Real-Exo/PP113/README.md

Portable version of the Project 113 headphone amplifier, with added BlueTooth and 3D printable case.
Powered by 4 removable 18650 Li-ion cells, have to be charged externally.
Kicad 7.0 schematics & PCB layouts.
MPLAB X IDE firmware project.
FreeCAD case design files & gcode.
