Real-Exo/PP113/Portable Project 113 Headphone Amplifier/BOM/P113 BT Daughterboard.ods

# | Reference | Qty | Value | Footprint | DNP | Partcode
1 | C1, C3, C4, C5, C6 | 5 | 10µF | Capacitor_SMD:C_0805_2012Metric_Pad1.18x1.45mm_HandSolder |  | GRM21BR61H106KE43K
2 | C2 | 1 | 150pF | Capacitor_SMD:C_0805_2012Metric_Pad1.18x1.45mm_HandSolder |  | 885012007005
3 | J1 | 1 | BT Power | Connector_PinHeader_2.54mm:PinHeader_1x05_P2.54mm_Vertical |  | Standard 2.54 pin header
4 | J2 | 1 | BT Audio | Connector_PinHeader_2.54mm:PinHeader_1x05_P2.54mm_Vertical |  | Standard 2.54 pin header
5 | L1 | 1 | 100µH | Inductor_SMD:L_Changjiang_FNR4026S |  | SRN4026-101M
6 | L2 | 1 | TBD | Inductor_THT:L_Axial_L11.0mm_D4.5mm_P15.24mm_Horizontal_Fastron_MECC |  | Bridge or 100mH axial inductor for filtering
7 | MOD1 | 1 | MH-M18 | My_Footprints:MH-M18 |  | MH-M18 BT module
8 | R1, R2 | 2 | * | Resistor_SMD:R_0805_2012Metric_Pad1.20x1.40mm_HandSolder | X
9 | R3 | 1 | # | Resistor_SMD:R_0805_2012Metric_Pad1.20x1.40mm_HandSolder | X
10 | R4 | 1 | 126K | Resistor_SMD:R_0805_2012Metric_Pad1.20x1.40mm_HandSolder |  | RT0805BRE07126KL
11 | R5 | 1 | 24K | Resistor_SMD:R_0805_2012Metric_Pad1.20x1.40mm_HandSolder |  | RT0805FRE0724KL
12 | R6, R7 | 2 | 0 | Resistor_SMD:R_0805_2012Metric_Pad1.20x1.40mm_HandSolder |  | 0 ohm bridge
13 | R8, R9 | 2 | 22K | Resistor_SMD:R_0805_2012Metric_Pad1.20x1.40mm_HandSolder |  | RK73B2ATTD223J
14 | U1 | 1 | RT6208 | Package_TO_SOT_SMD:SOT-23-6 |  | RT6208GE
