Real-Exo/PP113/Portable Project 113 Headphone Amplifier/BOM/P113 Portable Headphone Amp.ods

# | Reference | Qty | Value | Footprint | DNP | Partcode
1 | BT11 | 1 | ~ | My_Footprints:Quad PCB mounted 18650 li-ion holder |  | BK-18650-PC8
2 | C11, C12, C13, C14, C15, C16 | 6 | 2.2µF | Capacitor_SMD:C_1206_3216Metric_Pad1.33x1.80mm_HandSolder |  | C1206C225J5REC7210
3 | C17, C18, C19, C21, C31, C32, C47, C48, C49, C110 | 10 | 100n | My_Footprints:C_0402_1005Metric_Pad0.74x0.62mm_HandSolder |  | CL05A104KA5NNNC
4 | C22, C23, C24, C27, C212, C213, C218 | 7 | 10µF | Capacitor_SMD:C_0805_2012Metric_Pad1.18x1.45mm_HandSolder |  | GRM21BR61H106KE43K
5 | C25, C26, C43, C44, C45, C46, C54, C55, C56, C512, C513, C514, C517, C518 | 14 | 100n | Capacitor_SMD:C_0805_2012Metric_Pad1.18x1.45mm_HandSolder |  | CL21B104KBCNFNC
6 | C28, C29, C210, C211 | 4 | 100µF | Capacitor_THT:CP_Radial_D6.3mm_P2.50mm |  | ESL107M035AE3AA
7 | C41, C42 | 2 | 1µF | My_Footprints:WIMA_1µF |  | MKP2C041001N00MN00
8 | C51, C59 | 2 | 100µF | Capacitor_SMD:CP_Elec_8x5.4 |  | UWP0J101MCL1GB
9 | C52, C53, C510, C511 | 4 | 100µF | Capacitor_SMD:CP_Elec_6.3x5.4_Nichicon |  | UWX0J101MCL1GB
10 | C57, C58, C515, C516 | 4 | 47µF | Capacitor_SMD:CP_Elec_6.3x5.7 |  | A768EB476M1VLAE042
11 | C214, C215, C216, C217, C219 | 5 | 1µF | Capacitor_SMD:C_0805_2012Metric_Pad1.18x1.45mm_HandSolder |  | CL21B105KBFNNNE
12 | C220 | 1 | 1µF | My_Footprints:C_0402_1005Metric_Pad0.74x0.62mm_HandSolder |  | GRM155R61E105KA12J
13 | D11, D12, D23, D24, D27 | 5 | SBR0560S1Q | Diode_SMD:D_SOD-123 |  | SBR0560S1Q-7 | ATTENTION: Errata, replace D12 with 0 ohm bridge
14 | D21, D22 | 2 | BZT52C18 | Diode_SMD:D_SOD-123 |  | BZT52C18-7-F
15 | D25, D26, D51, D52, D53, D54 | 6 | 1N4148W | Diode_SMD:D_SOD-123 |  | 1N4148W-TP
16 | D31 | 1 | LED | My_Footprints:LED_Holder |  | 3mm 2color 2pin LED
17 | D41, D42, D55, D56 | 4 | SMF20CA | Diode_SMD:D_SOD-123 |  | SMF20CA
18 | D43, D45, D47, D49 | 4 | BAS16TS | Diode_SMD:D_SOD-523 |  | BAS16TS_R1_00001
19 | D44, D46, D48, D410 | 4 | 5.1V | Diode_SMD:D_SOD-323 |  | PZU5.1B1A,115
20 | D411, D412, D413 | 3 | BAS16TS | Diode_SMD:D_SOD-523 |  | BAS16TS_R1_00001
21 | F11 | 1 | PTC 0.35A | Fuse:Fuse_1812_4532Metric_Pad1.30x3.40mm_HandSolder |  | SMD1812B035TF/30
22 | F12, F13, F14, F15, F16 | 5 | PTC 0.05A | Fuse:Fuse_1206_3216Metric_Pad1.42x1.75mm_HandSolder |  | SMD1206B005TF
23 | J31 | 1 | ICSP | Connector_PinSocket_2.54mm:PinSocket_1x05_P2.54mm_Vertical |  | SSW-105-01-T-S
24 | J41, J51 | 2 | Line in, HP out | My_Footprints:3-5mm_connector |  | STX-3120-5B
25 | J42 | 1 | BT daughterboard audio | Connector_PinSocket_2.54mm:PinSocket_1x05_P2.54mm_Vertical |  | SSW-105-01-T-S
26 | J43 | 1 | BT daughterboard power | Connector_PinSocket_2.54mm:PinSocket_1x05_P2.54mm_Vertical |  | SSW-105-01-T-S
27 | Q11, Q12, Q13, Q14 | 4 | BSS84W | Package_TO_SOT_SMD:SOT-323_SC-70 |  | BSS84WT106
28 | Q15, Q16, Q17, Q18, Q41, Q42, Q43 | 7 | BSS138W | Package_TO_SOT_SMD:SOT-323_SC-70 |  | BSS138W-7-F
29 | Q21, Q23 | 2 | BC817 | Package_TO_SOT_SMD:SOT-23 |  | BC817-40,215
30 | Q22, Q24 | 2 | BC807 | Package_TO_SOT_SMD:SOT-23 |  | BC807-40,215
31 | Q25, Q26 | 2 | DMC3025LSD | Package_SO:SO-8_3.9x4.9mm_P1.27mm |  | DMC3025LSD-13
32 | Q51, Q53 | 2 | BCP56 | Package_TO_SOT_SMD:SOT-223-3_TabPin2 |  | BCP56-10HX
33 | Q52, Q54 | 2 | BCP53 | Package_TO_SOT_SMD:SOT-223-3_TabPin2 |  | BCP53-10HX
34 | R11, R12, R13, R14, R21, R22, R23, R24, R25, R26, R27, R28, R33, R46, R47, R49, R113, R410, R412 | 19 | 100K | My_Footprints:R_0402_1005Metric_Pad0.72x0.64mm_HandSolder |  | ERJ-2GEJ104X
35 | R15, R16, R17, R18, R19, R45, R48, R110, R111, R112, R411 | 11 | 1K | My_Footprints:R_0402_1005Metric_Pad0.72x0.64mm_HandSolder |  | ERJ-2GEJ102X
36 | R29, R52, R210, R213, R214, R511 | 6 | 100 | Resistor_SMD:R_0805_2012Metric_Pad1.20x1.40mm_HandSolder |  | RK73B2ATTD101J
37 | R31 | 1 | 10K | My_Footprints:R_0402_1005Metric_Pad0.72x0.64mm_HandSolder |  | ERJ-2GEJ103X
38 | R32 | 1 | 470 | My_Footprints:R_0402_1005Metric_Pad0.72x0.64mm_HandSolder |  | ERJ-2GEJ470X
39 | R34 | 1 | 2K2 | Resistor_SMD:R_0805_2012Metric_Pad1.20x1.40mm_HandSolder |  | RK73B2ATTD222J
40 | R41, R42 | 2 | 22K | Resistor_SMD:R_1206_3216Metric_Pad1.30x1.75mm_HandSolder |  | ERJ-P08J223V
41 | R43, R44 | 2 | 1K | Resistor_SMD:R_2512_6332Metric_Pad1.40x3.35mm_HandSolder |  | CRGP2512F1K0
42 | R53, R512 | 2 | 1K | Resistor_SMD:R_0805_2012Metric_Pad1.20x1.40mm_HandSolder |  | RK73B2ATTD102J
43 | R54, R513 | 2 | 22K | Resistor_SMD:R_0805_2012Metric_Pad1.20x1.40mm_HandSolder |  | RK73B2ATTD223J
44 | R55, R56, R514, R515 | 4 | 6K8 | Resistor_SMD:R_0805_2012Metric_Pad1.20x1.40mm_HandSolder |  | RK73B2ATTD682J
45 | R57, R58, R510, R516, R517, R519 | 6 | 10 | Resistor_SMD:R_1206_3216Metric_Pad1.30x1.75mm_HandSolder |  | RC1206JR-7W10RL
46 | R59, R518 | 2 | 100 | Resistor_SMD:R_2512_6332Metric_Pad1.40x3.35mm_HandSolder |  | 3522100RJT
47 | R114, R115, R116, R117 | 4 | 12K | My_Footprints:R_0402_1005Metric_Pad0.72x0.64mm_HandSolder |  | ERJ-2GEJ123X
48 | R118, R119, R120, R121 | 4 | 1K5 | My_Footprints:R_0402_1005Metric_Pad0.72x0.64mm_HandSolder |  | ERJ-2GEJ152X
49 | R211, R212 | 2 | 1 | Resistor_SMD:R_1206_3216Metric_Pad1.30x1.75mm_HandSolder |  | ERJ-P08J1R0V
50 | R215, R216, R217 | 3 | 10 | Resistor_SMD:R_0805_2012Metric_Pad1.20x1.40mm_HandSolder |  | RK73B2ATTD100J
51 | R218 | 1 | 0 | My_Footprints:R_0402_1005Metric_Pad0.72x0.64mm_HandSolder | X | ERJ-2GE0R00X
52 | RV51 | 1 | 10K | Potentiometer_THT:Potentiometer_Alps_RK09L_Double_Horizontal |  | RK09L12B0A4S
53 | SW31 | 1 | Power/Function | My_Footprints:SW_LC1258EENP |  | LC1258OASP
54 | U21 | 1 | CD40109 | Package_SO:TSSOP-16_4.4x5mm_P0.65mm |  | CD40109BPWR
55 | U22 | 1 | TCR1HF50B | Package_TO_SOT_SMD:TSOT-23-5 |  | TCR1HF50BLMCT
56 | U31 | 1 | PIC16F18446-I/SS | Package_SO:SSOP-20_5.3x7.2mm_P0.65mm |  | PIC16F18446-I/SS
57 | U41 | 1 | CD4052 | Package_SO:TSSOP-16_4.4x5mm_P0.65mm |  | CD4052BPWR
58 | U42, U51 | 2 | NJM5532 | Package_SO:SOIC-8W_5.3x5.3mm_P1.27mm |  | NJM5532M
