Real-Exo/PP113/Portable Project 113 Headphone Amplifier/Case/PP113_power_button.FCStd

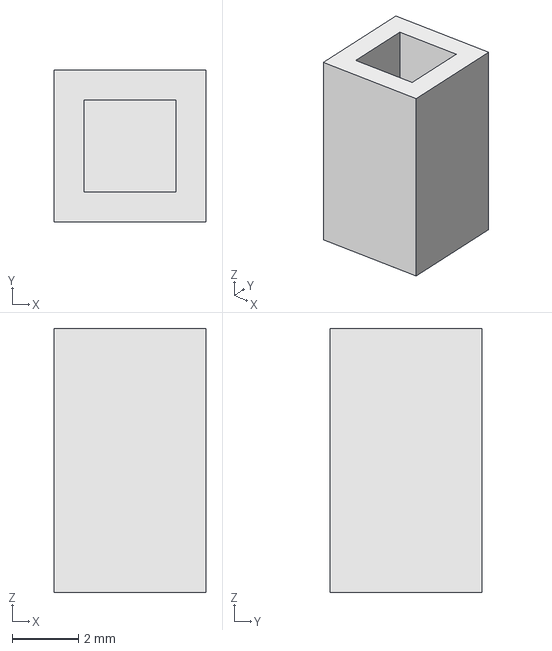
[picture p2: CAD file, 2024-12-13]
Portable Project 113 Headphone Amplifier/Case/PP113_power_button.FCStd
4.60 x 4.60 x 8.00 mm
