Real-Exo/PP113/Portable Project 113 Headphone Amplifier/Case/P113_case_front.FCStd

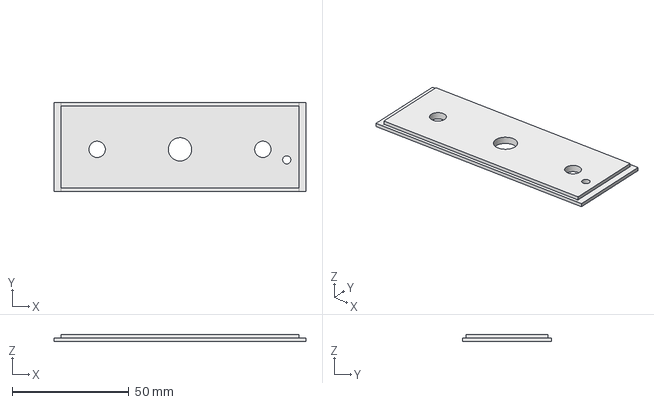
[picture p3: CAD file, 2024-12-13]
Portable Project 113 Headphone Amplifier/Case/P113_case_front.FCStd
108.0 x 38.0 x 3.00 mm
