Real-Exo/PP113/Portable Project 113 Headphone Amplifier/Case/PP113_case_top.FCStd

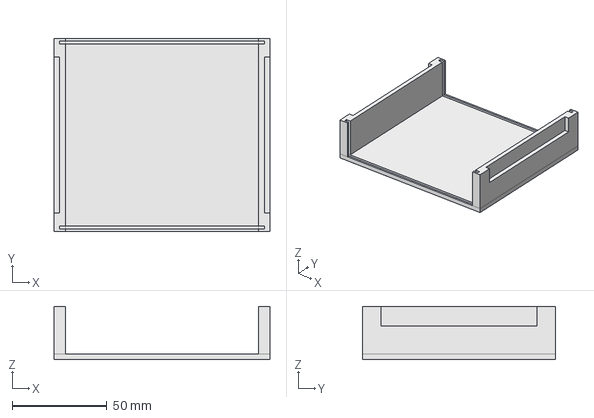
[picture p4: CAD file, 2024-12-13]
Portable Project 113 Headphone Amplifier/Case/PP113_case_top.FCStd
114.0 x 102.0 x 28.0 mm
