Real-Exo/PP113/Portable Project 113 Headphone Amplifier/Case/PP113_case_bottom.FCStd

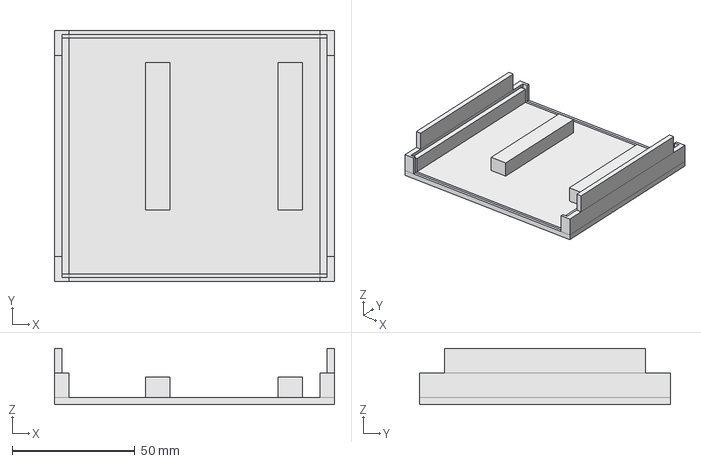
[picture p5: CAD file, 2024-12-13]
Portable Project 113 Headphone Amplifier/Case/PP113_case_bottom.FCStd
114.0 x 102.0 x 23.0 mm
