Real-Exo/PP113/Portable Project 113 Headphone Amplifier/Kicad/PP113/P113 Portable Headphone Amp.kicad_pcb

## KiCad design Portable Project 113 Headphone Amplifier/Kicad/PP113/P113 Portable Headphone Amp.kicad_pcb (2024-12-13)

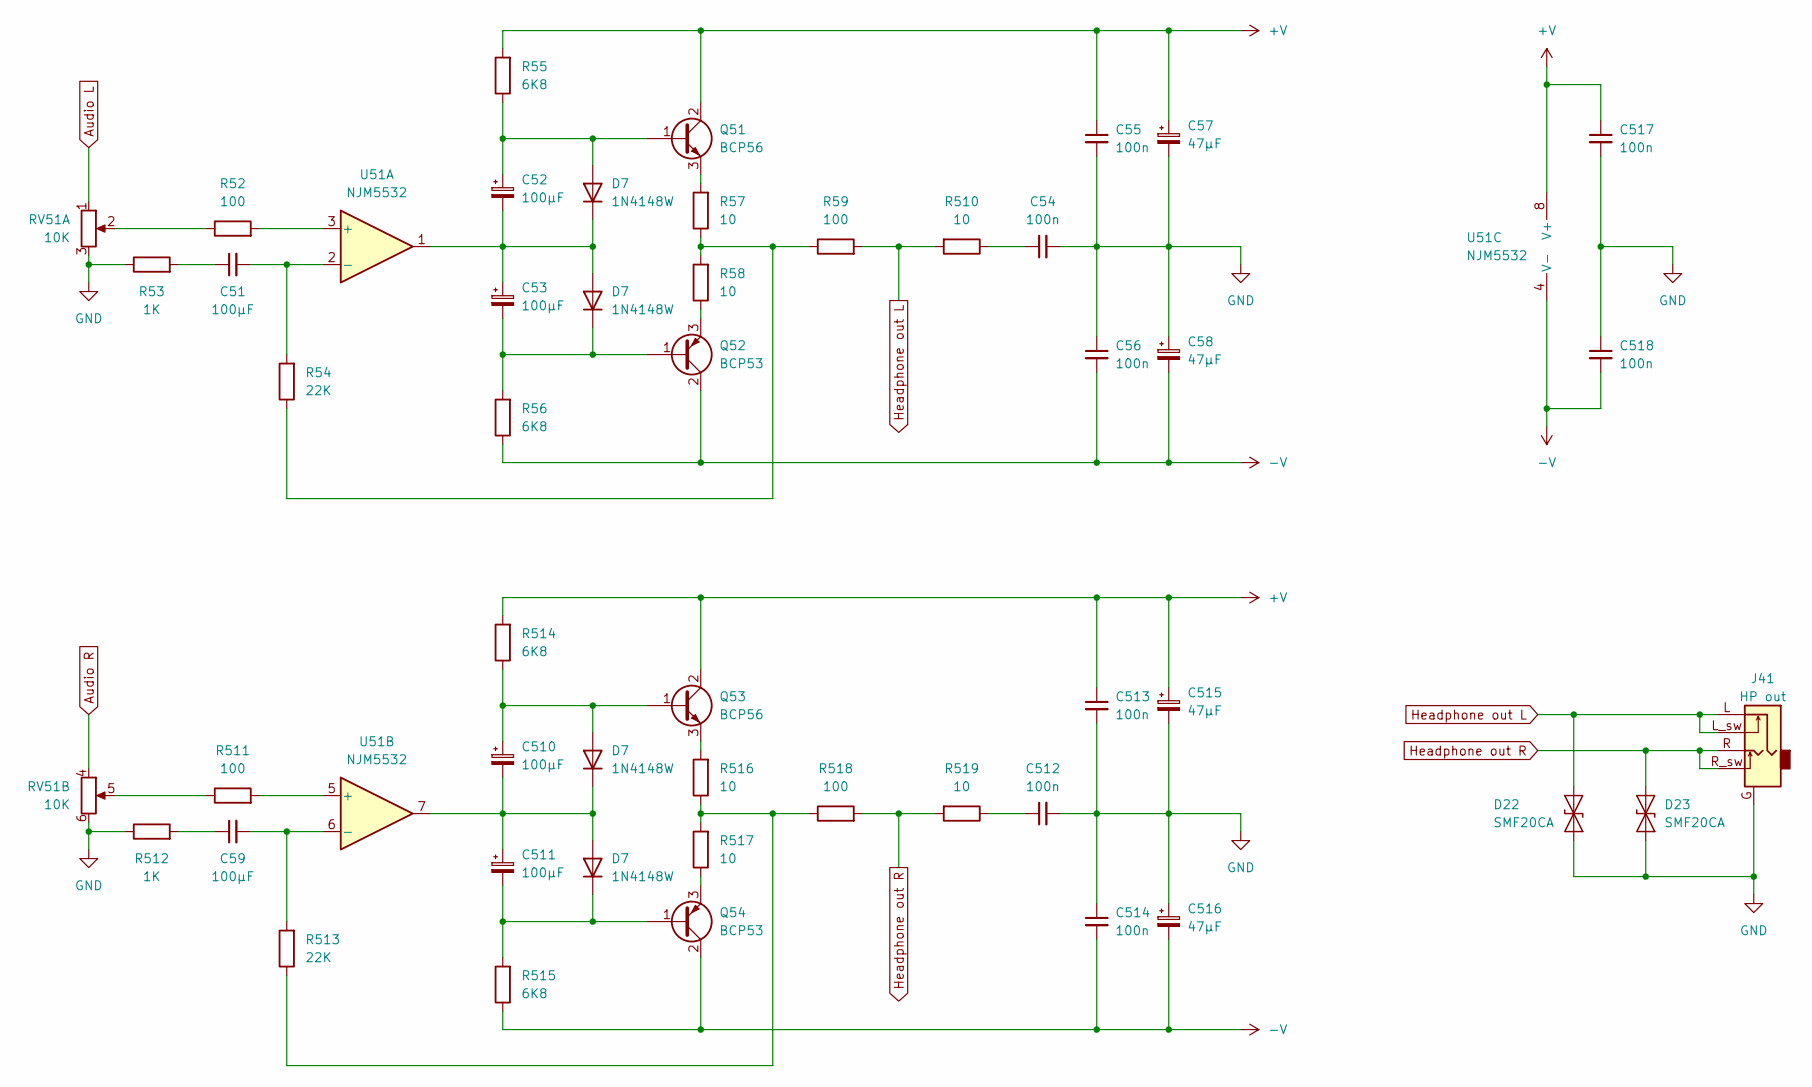
[picture p6: schematic Amplifier.kicad_sch]

Parts:
C51, C59: 100µF; CP_Elec_8x5.4
C52, C53, C510, C511: 100µF; CP_Elec_6.3x5.4_Nichicon
C54, C55, C56, C512, C513, C514, C517, C518: 100n; C_0805_2012Metric_Pad1.18x1.45mm_HandSolder
C57, C58, C515, C516: 47µF; CP_Elec_6.3x5.7
D7: 1N4148W; D_SOD-123
D22, D23: SMF20CA; D_SOD-123
J41: HP out; 3-5mm_connector
Q51, Q53: BCP56; SOT-223-3_TabPin2
Q52, Q54: BCP53; SOT-223-3_TabPin2
R52, R511: 100; R_0805_2012Metric_Pad1.20x1.40mm_HandSolder
R53, R512: 1K; R_0805_2012Metric_Pad1.20x1.40mm_HandSolder
R54, R513: 22K; R_0805_2012Metric_Pad1.20x1.40mm_HandSolder
R55, R56, R514, R515: 6K8; R_0805_2012Metric_Pad1.20x1.40mm_HandSolder
R57, R58, R510, R516, R517, R519: 10; R_1206_3216Metric_Pad1.30x1.75mm_HandSolder
R59, R518: 100; R_2512_6332Metric_Pad1.40x3.35mm_HandSolder
RV51: 10K; Potentiometer_Alps_RK09L_Double_Horizontal
U51: NJM5532; SOIC-8W_5.3x5.3mm_P1.27mm

Connections:
+V: C55.1, C57.1, C513.1, C515.1, C517.1, Q51.2 (C), Q53.2 (C), R55.2, R514.2, U51.8 (V+); also elsewhere on the board
-V: C56.2, C58.2, C514.2, C516.2, C518.2, Q52.2 (C), Q54.2 (C), R56.1, R515.1, U51.4 (V-); also elsewhere on the board
Audio L: RV51.1; also elsewhere on the board
Audio R: RV51.4; also elsewhere on the board
unnamed: C51.1, R53.2
unnamed: C54.1, R510.1
unnamed: C59.1, R512.2
unnamed: C512.1, R519.1
unnamed 55: C52.1, Q51.1 (B), R55.1; also elsewhere on the board
unnamed 56: C52.2, C53.1, U51.1; also elsewhere on the board
unnamed 57: C53.2, Q52.1 (B), R56.2; also elsewhere on the board
unnamed 58: C510.1, Q53.1 (B), R514.1; also elsewhere on the board
unnamed 59: C510.2, C511.1, U51.7; also elsewhere on the board
unnamed 60: C511.2, Q54.1 (B), R515.2; also elsewhere on the board
unnamed: Q51.3 (E), R57.2
unnamed: Q52.3 (E), R58.1
unnamed: Q53.3 (E), R516.2
unnamed: Q54.3 (E), R517.1
unnamed: R52.1, RV51.2
unnamed: R54.1, R57.1, R58.2, R59.1
unnamed: R511.1, RV51.5
unnamed: R513.1, R516.1, R517.2, R518.1
unnamed: R52.2, U51.3 (+)
unnamed: C51.2, R54.2, U51.2 (-)
unnamed: R511.2, U51.5 (+)
unnamed: C59.2, R513.2, U51.6 (-)

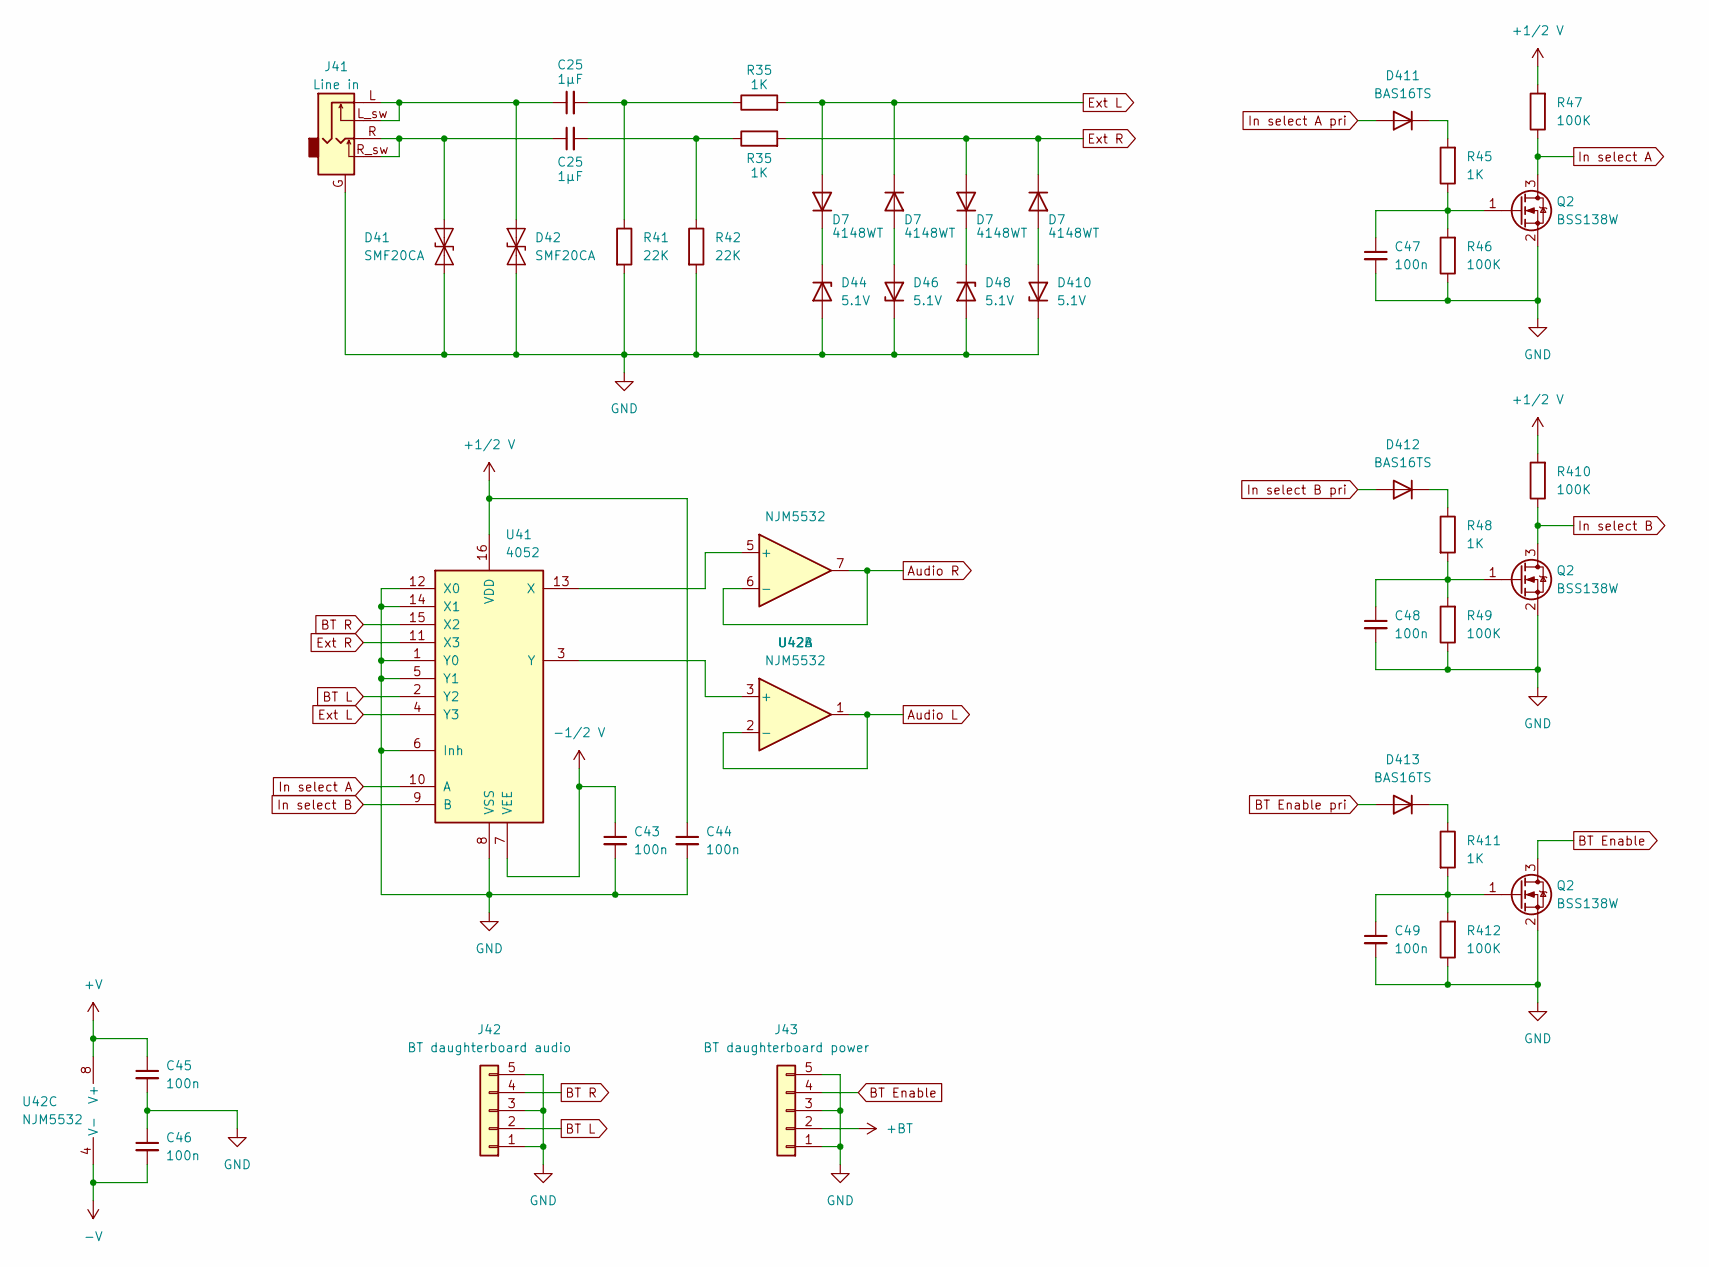
[picture p7: schematic Input_selector.kicad_sch]

Parts:
C25: 1µF; WIMA_1µF
C43, C44, C45, C46: 100n; C_0805_2012Metric_Pad1.18x1.45mm_HandSolder
C47, C48, C49: 100n; C_0402_1005Metric_Pad0.74x0.62mm_HandSolder JLC
D7: 4148WT; D_SOD-523
D41, D42: SMF20CA; D_SOD-123
D44, D46, D48, D410: 5.1V; D_SOD-323
D411, D412, D413: BAS16TS; D_SOD-523
J41: Line in; 3-5mm_connector
J42: BT daughterboard audio; PinSocket_1x05_P2.54mm_Vertical
J43: BT daughterboard power; PinSocket_1x05_P2.54mm_Vertical
Q2: BSS138W; SOT-323_SC-70
R35: 1K; R_2512_6332Metric_Pad1.40x3.35mm_HandSolder
R41, R42: 22K; R_1206_3216Metric_Pad1.30x1.75mm_HandSolder
R45, R48, R411: 1K; R_0402_1005Metric_Pad0.72x0.64mm_HandSolder JLC
R46, R47, R49, R410, R412: 100K; R_0402_1005Metric_Pad0.72x0.64mm_HandSolder JLC
U41: 4052; TSSOP-16_4.4x5mm_P0.65mm
U42: NJM5532; SOIC-8W_5.3x5.3mm_P1.27mm

Connections:
+1/2_V: C44.1, R47.2, R410.2, U41.16 (VDD); also elsewhere on the board
+BT: J43.2; also elsewhere on the board
+V: C45.1, U42.8 (V+); also elsewhere on the board
-1/2_V: C43.1, U41.7 (VEE); also elsewhere on the board
-V: C46.2, U42.4 (V-); also elsewhere on the board
Audio L: U42.1, U42.2 (-); also elsewhere on the board
Audio R: U42.6 (-), U42.7; also elsewhere on the board
BT Enable: J43.4; also elsewhere on the board
BT Enable pri: D413.2 (A); also elsewhere on the board
BT L: J42.2, U41.2 (Y2)
BT R: J42.4, U41.15 (X2)
Ext L: U41.4 (Y3); also elsewhere on the board
Ext R: U41.11 (X3); also elsewhere on the board
In select A: R47.1, U41.10 (A); also elsewhere on the board
In select A pri: D411.2 (A); also elsewhere on the board
In select B: R410.1, U41.9 (B); also elsewhere on the board
In select B pri: D412.2 (A); also elsewhere on the board
unnamed 52: D44.1 (K); also elsewhere on the board
unnamed 53: D46.2 (A); also elsewhere on the board
unnamed 54: D48.1 (K); also elsewhere on the board
unnamed 61: D410.2 (A); also elsewhere on the board
unnamed: D411.1 (K), R45.2
unnamed: D412.1 (K), R48.1
unnamed: D413.1 (K), R411.1
unnamed 92: C47.1, R45.1, R46.2; also elsewhere on the board
unnamed 93: C48.1, R48.2, R49.2; also elsewhere on the board
unnamed 94: C49.1, R411.2, R412.2; also elsewhere on the board
unnamed: U41.13 (X), U42.5 (+)
unnamed: U41.3 (Y), U42.3 (+)

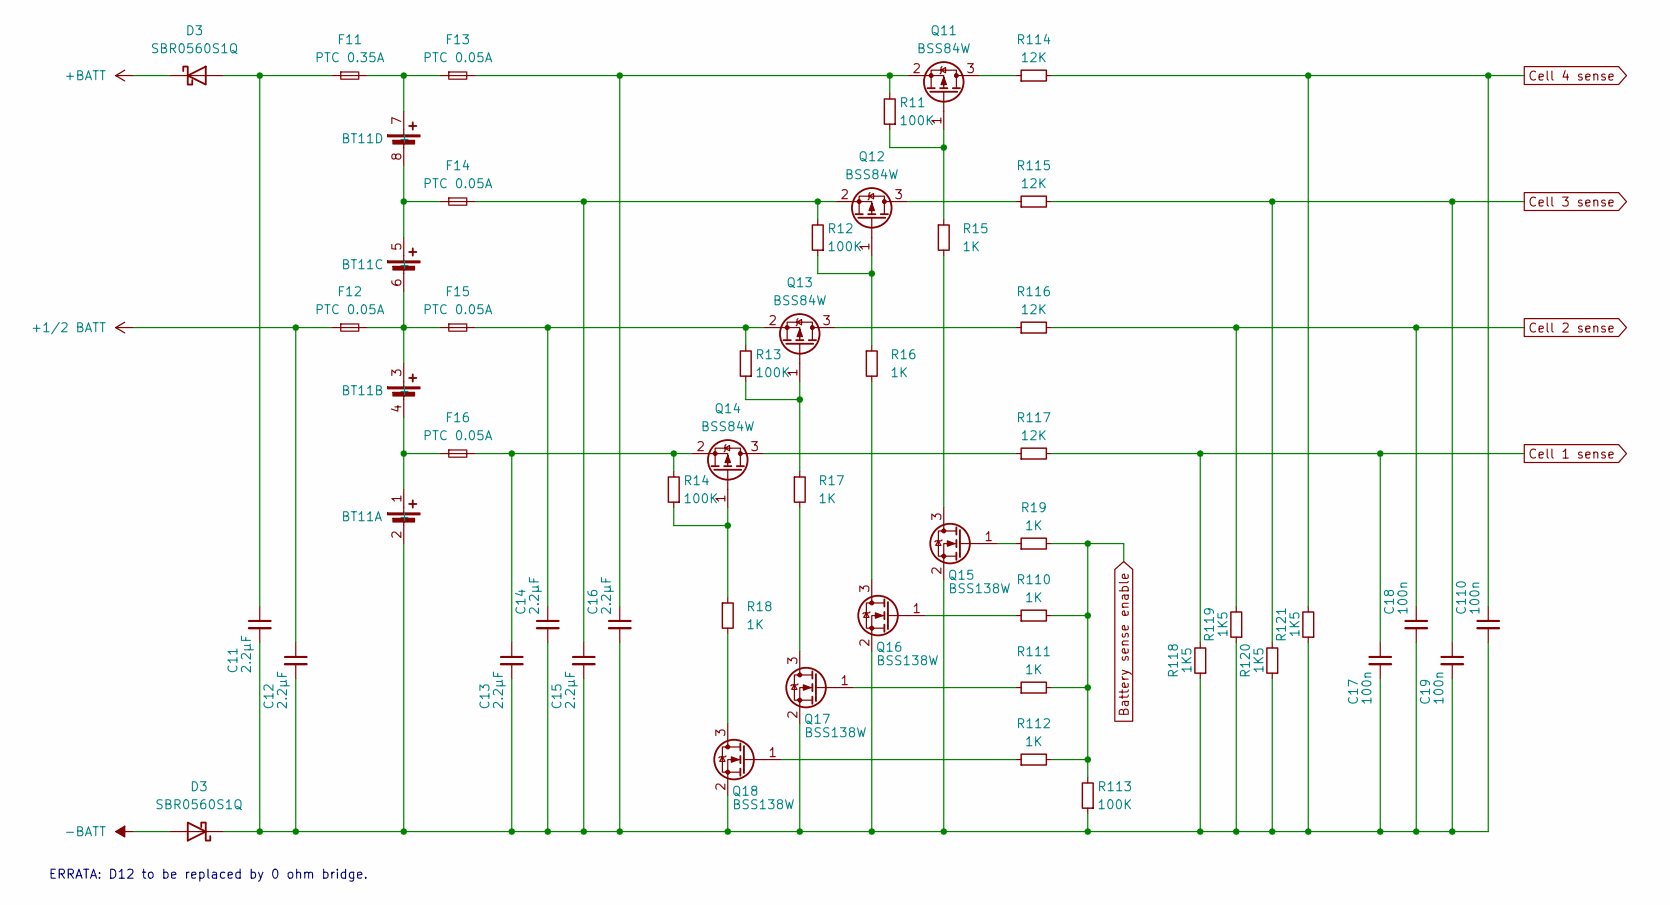
[picture p8: schematic Battery_guard.kicad_sch]

Parts:
BT11: Quad PCB mounted 18650 li-ion holder
C11, C12, C13, C14, C15, C16: 2.2µF; C_1206_3216Metric_Pad1.33x1.80mm_HandSolder
C17, C18, C19, C110: 100n; C_0402_1005Metric_Pad0.74x0.62mm_HandSolder JLC
D3: SBR0560S1Q; D_SOD-123
F11: PTC 0.35A; Fuse_1812_4532Metric_Pad1.30x3.40mm_HandSolder
F12, F13, F14, F15, F16: PTC 0.05A; Fuse_1206_3216Metric_Pad1.42x1.75mm_HandSolder
Q11, Q12, Q13, Q14: BSS84W; SOT-323_SC-70
Q15, Q16, Q17, Q18: BSS138W; SOT-323_SC-70
R11, R12, R13, R14, R113: 100K; R_0402_1005Metric_Pad0.72x0.64mm_HandSolder JLC
R15, R16, R17, R18, R19, R110, R111, R112: 1K; R_0402_1005Metric_Pad0.72x0.64mm_HandSolder JLC
R114, R115, R116, R117: 12K; R_0402_1005Metric_Pad0.72x0.64mm_HandSolder JLC
R118, R119, R120, R121: 1K5; R_0402_1005Metric_Pad0.72x0.64mm_HandSolder JLC

Connections:
+1/2_BATT: C12.1, F12.1; also elsewhere on the board
Battery sense enable: R19.2, R110.2, R111.2, R112.2, R113.2; also elsewhere on the board
Cell 1 sense: C17.1, R117.2, R118.2; also elsewhere on the board
Cell 2 sense: C18.1, R116.2, R119.2; also elsewhere on the board
Cell 3 sense: C19.1, R115.2, R120.2; also elsewhere on the board
Cell 4 sense: C110.1, R114.2, R121.2; also elsewhere on the board
unnamed: BT11.1 (+), BT11.4 (-), F16.1
unnamed 36: BT11.2 (-), C11.2, C12.2, C13.2, C14.2, C15.2, C16.2, C17.2, C18.2, C19.2, C110.2, Q15.2 (S), Q16.2 (S), Q17.2 (S), Q18.2 (S), R113.1, R118.1, R119.1, R120.1, R121.1; also elsewhere on the board
unnamed: BT11.3 (+), BT11.6 (-), F12.2, F15.1
unnamed: BT11.5 (+), BT11.8 (-), F14.1
unnamed: BT11.7 (+), F11.2, F13.1
unnamed 45: C11.1, F11.1; also elsewhere on the board
unnamed: Q11.3 (D), R114.1
unnamed: Q11.1 (G), R11.1, R15.1
unnamed: C16.1, F13.2, Q11.2 (S), R11.2
unnamed: Q12.3 (D), R115.1
unnamed: Q12.1 (G), R12.1, R16.1
unnamed: C15.1, F14.2, Q12.2 (S), R12.2
unnamed: Q13.3 (D), R116.1
unnamed: Q13.1 (G), R13.1, R17.1
unnamed: C14.1, F15.2, Q13.2 (S), R13.2
unnamed: Q14.3 (D), R117.1
unnamed: Q14.1 (G), R14.1, R18.1
unnamed: C13.1, F16.2, Q14.2 (S), R14.2
unnamed: Q15.3 (D), R15.2
unnamed: Q15.1 (G), R19.1
unnamed: Q16.3 (D), R16.2
unnamed: Q16.1 (G), R110.1
unnamed: Q17.3 (D), R17.2
unnamed: Q17.1 (G), R111.1
unnamed: Q18.3 (D), R18.2
unnamed: Q18.1 (G), R112.1

Notes on the sheet:
ERRATA: D12 to be replaced by 0 ohm bridge.

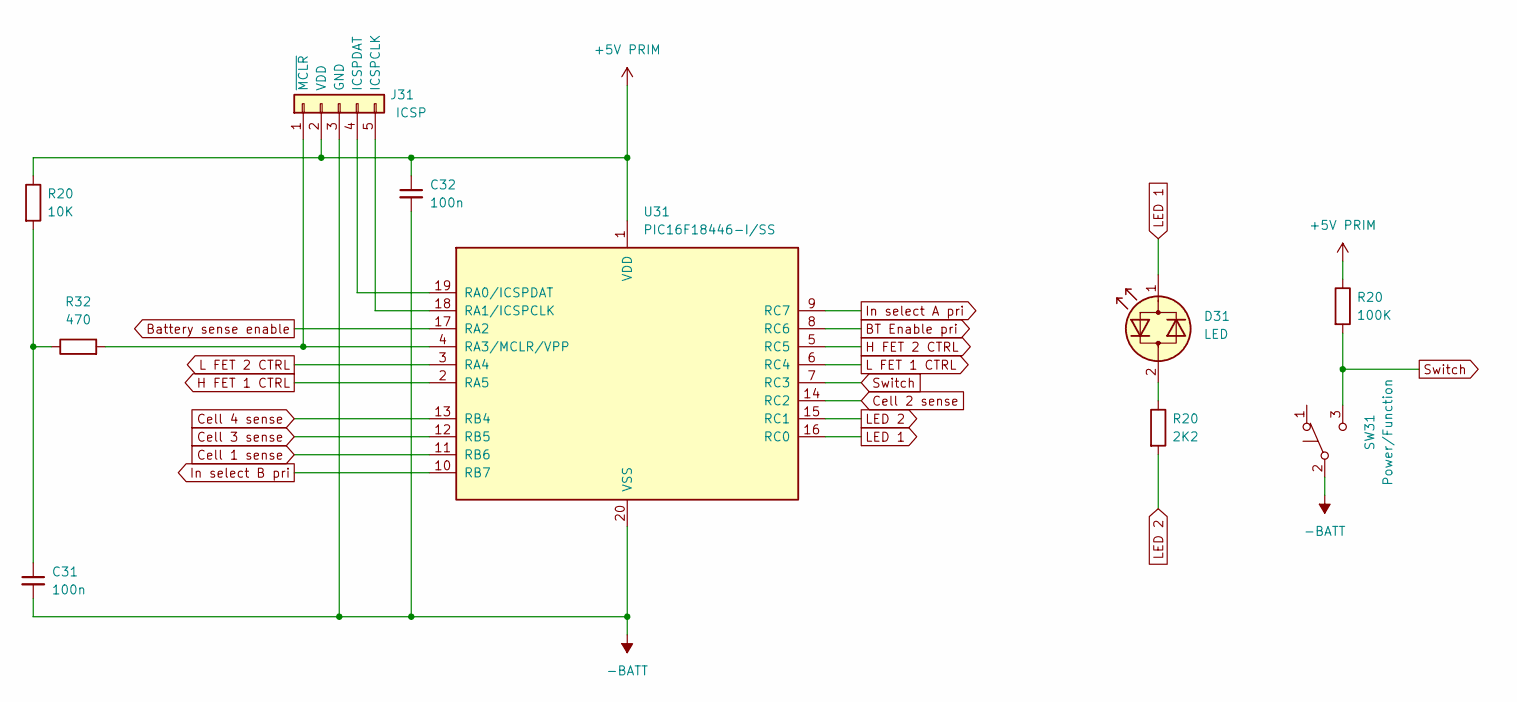
[picture p9: schematic Microcontroller.kicad_sch]

Parts:
C31, C32: 100n; C_0402_1005Metric_Pad0.74x0.62mm_HandSolder JLC
D31: LED; LED_Holder
J31: ICSP; PinSocket_1x05_P2.54mm_Vertical
R20: 2K2; R_0805_2012Metric_Pad1.20x1.40mm_HandSolder
R32: 470; R_0402_1005Metric_Pad0.72x0.64mm_HandSolder JLC
SW31: Power/Function; SW_LC1258EENP
U31: PIC16F18446-I/SS; SSOP-20_5.3x7.2mm_P0.65mm

Connections:
+5V_PRIM: C32.1, J31.2 (VDD), U31.1 (VDD); also elsewhere on the board
BT Enable pri: U31.8 (RC6); also elsewhere on the board
Battery sense enable: U31.17 (RA2); also elsewhere on the board
Cell 1 sense: U31.11 (RB6); also elsewhere on the board
Cell 2 sense: U31.14 (RC2); also elsewhere on the board
Cell 3 sense: U31.12 (RB5); also elsewhere on the board
Cell 4 sense: U31.13 (RB4); also elsewhere on the board
H FET 1 CTRL: U31.2 (RA5); also elsewhere on the board
H FET 2 CTRL: U31.5 (RC5); also elsewhere on the board
In select A pri: U31.9 (RC7); also elsewhere on the board
In select B pri: U31.10 (RB7); also elsewhere on the board
L FET 1 CTRL: U31.6 (RC4); also elsewhere on the board
L FET 2 CTRL: U31.3 (RA4); also elsewhere on the board
LED 1: D31.1 (KA), U31.16 (RC0)
LED 2: U31.15 (RC1); also elsewhere on the board
unnamed 40: C31.1, R32.1; also elsewhere on the board
unnamed 51: D31.2 (AK); also elsewhere on the board
unnamed: J31.5 (ICSPCLK), U31.18 (RA1/ICSPCLK)
unnamed: J31.4 (ICSPDAT), U31.19 (RA0/ICSPDAT)
unnamed: J31.1 (~MCLR), R32.2, U31.4 (RA3/MCLR/VPP)
Switch: SW31.3 (C), U31.7 (RC3); also elsewhere on the board

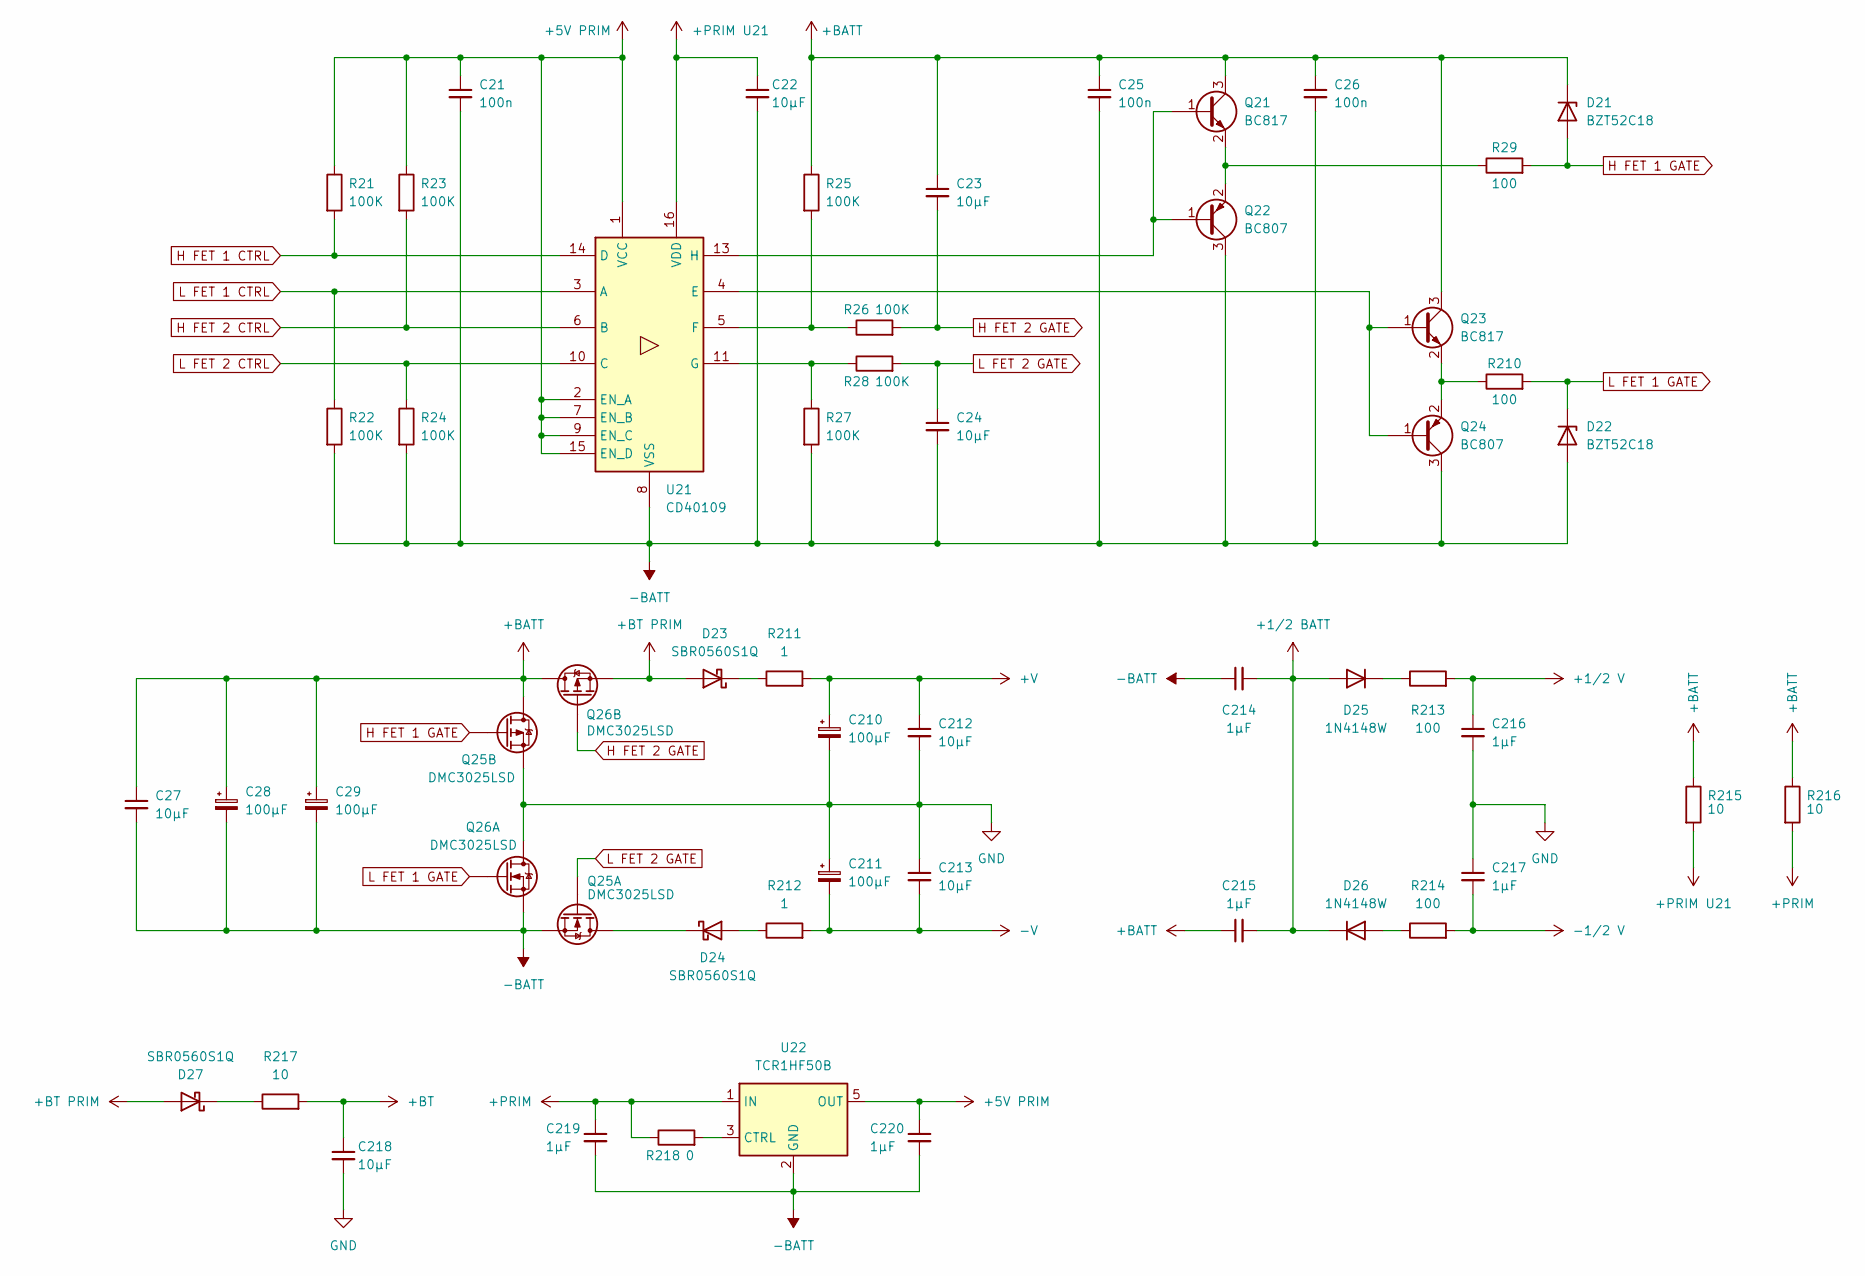
[picture p10: schematic Power_supply.kicad_sch]

Parts:
C21: 100n; C_0402_1005Metric_Pad0.74x0.62mm_HandSolder JLC
C22, C23, C24, C27, C212, C213, C218: 10µF; C_0805_2012Metric_Pad1.18x1.45mm_HandSolder
C25, C26: 100n; C_0805_2012Metric_Pad1.18x1.45mm_HandSolder
C28, C29, C210, C211: 100µF; CP_Radial_D6.3mm_P2.50mm
C214, C215, C216, C217, C219: 1µF; C_0805_2012Metric_Pad1.18x1.45mm_HandSolder
C220: 1µF; C_0402_1005Metric_Pad0.74x0.62mm_HandSolder JLC
D21, D22: BZT52C18; D_SOD-123
D23, D24, D27: SBR0560S1Q; D_SOD-123
D25, D26: 1N4148W; D_SOD-123
Q21, Q23: BC817; SOT-23
Q22, Q24: BC807; SOT-23
Q25, Q26: DMC3025LSD; SO-8_3.9x4.9mm_P1.27mm
R21, R22, R23, R24, R25, R26, R27, R28: 100K; R_0402_1005Metric_Pad0.72x0.64mm_HandSolder JLC
R29, R210, R213, R214: 100; R_0805_2012Metric_Pad1.20x1.40mm_HandSolder
R211, R212: 1; R_1206_3216Metric_Pad1.30x1.75mm_HandSolder
R215, R216, R217: 10; R_0805_2012Metric_Pad1.20x1.40mm_HandSolder
R218: 0; R_0402_1005Metric_Pad0.72x0.64mm_HandSolder JLC
U21: CD40109; TSSOP-16_4.4x5mm_P0.65mm
U22: TCR1HF50B; TSOT-23-5

Connections:
+1/2_BATT: C214.2, C215.2, D25.2 (A), D26.1 (K); also elsewhere on the board
+1/2_V: C216.1, R213.2; also elsewhere on the board
+5V_PRIM: C21.1, C220.1, R21.1, R23.1, U21.1 (VCC), U21.2 (EN_A), U21.7 (EN_B), U21.9 (EN_C), U21.15 (EN_D), U22.5 (OUT); also elsewhere on the board
+BT: C218.1, R217.2; also elsewhere on the board
+PRIM: C219.1, R216.2, R218.1, U22.1 (IN)
+PRIM_U21: C22.1, R215.2, U21.16 (VDD)
+V: C210.1, C212.1, R211.2; also elsewhere on the board
-1/2_V: C217.2, R214.2; also elsewhere on the board
-V: C211.2, C213.2, R212.2; also elsewhere on the board
H FET 1 CTRL: R21.2, U21.14 (D); also elsewhere on the board
H FET 1 GATE: D21.2 (A), Q25.4 (G1), R29.2
H FET 2 CTRL: R23.2, U21.6 (B); also elsewhere on the board
H FET 2 GATE: C23.2, Q26.4 (G1), R26.2
L FET 1 CTRL: R22.1, U21.3 (A); also elsewhere on the board
L FET 2 CTRL: R24.1, U21.10 (C); also elsewhere on the board
L FET 2 GATE: C24.1, Q25.2 (G2), R28.2
unnamed: D24.2 (A), R212.1
unnamed: D24.1 (K), Q25.7 (D2), Q25.8 (D2)
unnamed: D25.1 (K), R213.1
unnamed: D26.2 (A), R214.1
unnamed: D27.1 (K), R217.1
unnamed: Q21.1 (B), Q22.1 (B), U21.13 (H)
unnamed: Q21.2 (E), Q22.2 (E), R29.1
unnamed: Q23.1 (B), Q24.1 (B), U21.4 (E)
unnamed: Q23.2 (E), Q24.2 (E), R210.1
unnamed: R25.2, R26.1, U21.5 (F)
unnamed: R27.1, R28.1, U21.11 (G)
unnamed: R218.2, U22.3 (CTRL)

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
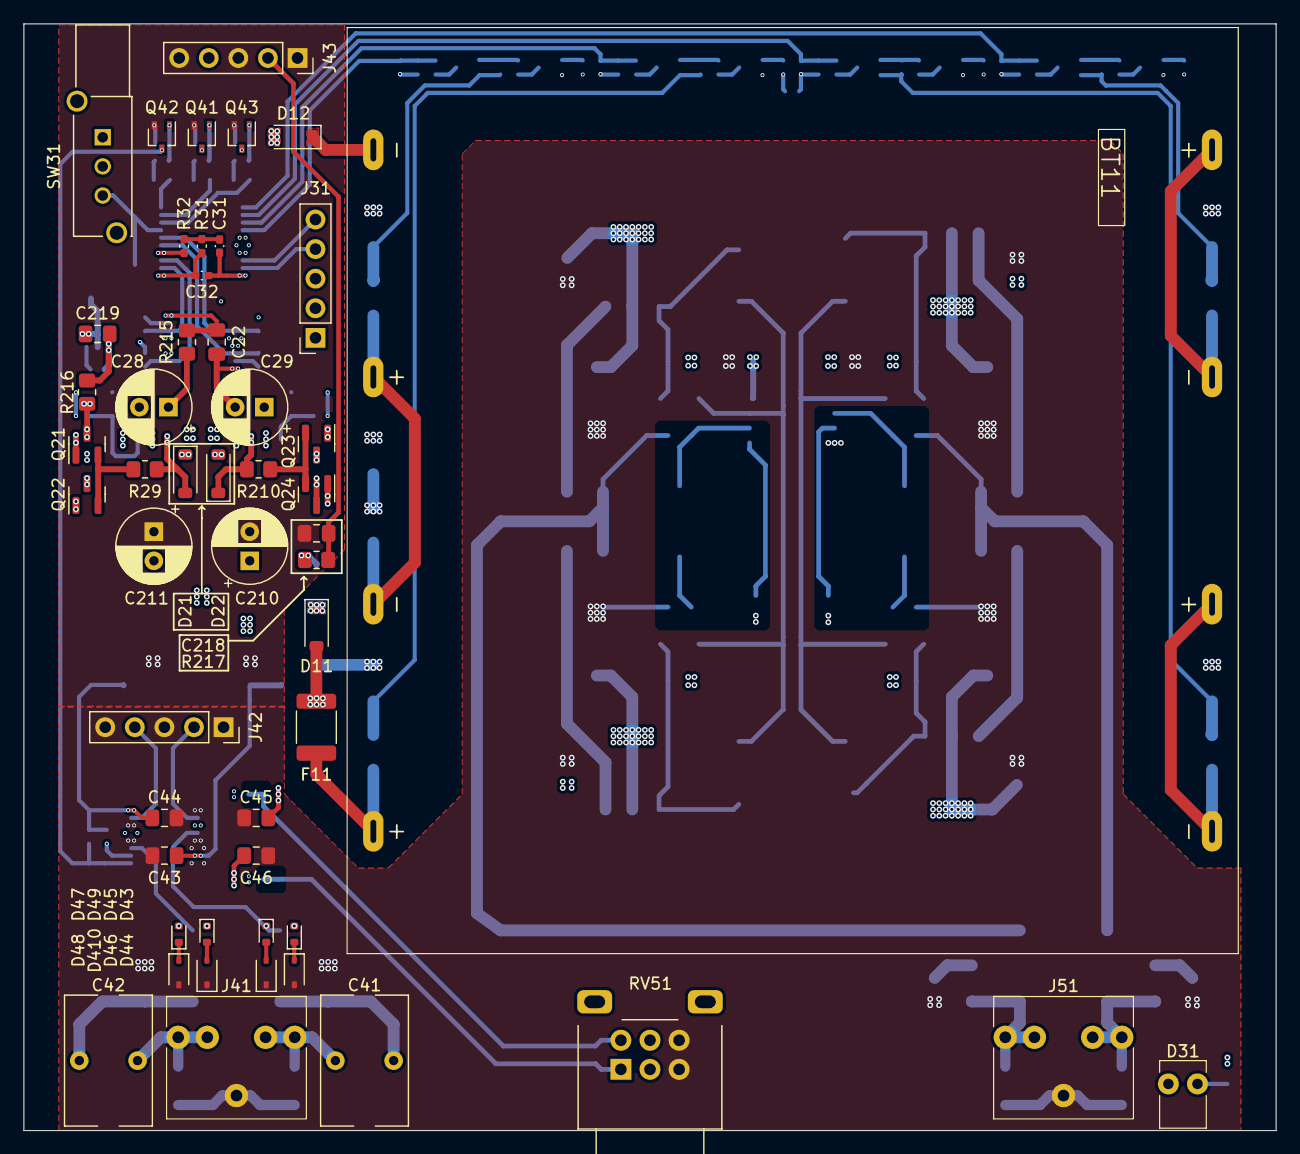
[picture p11: board P113 Portable Headphone Amp.kicad_pcb from above]

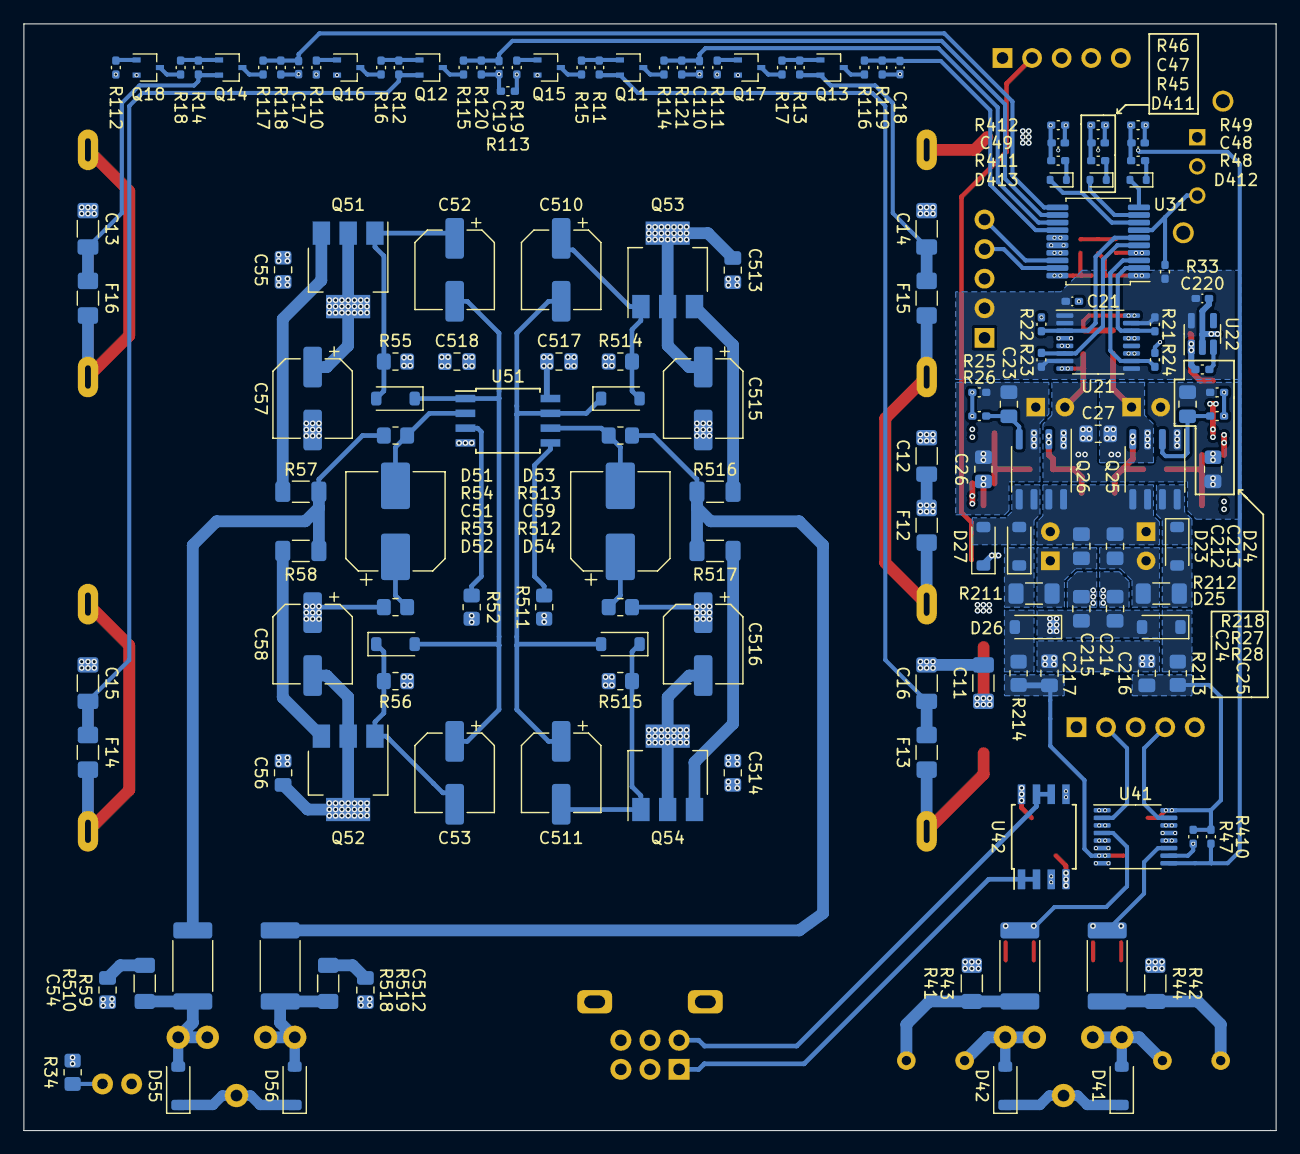
[picture p12: board P113 Portable Headphone Amp.kicad_pcb from below]

Board: 4 copper layers, 107.5 x 95.0 mm, 202 parts (151 on the bottom side), 125 nets.

Other parts of the board:
C41, C42: 1µF; WIMA_1µF
D11, D12: SBR0560S1Q; D_SOD-123
D43, D45, D47, D49: 4148WT; D_SOD-523
D51, D52, D53, D54: 1N4148W; D_SOD-123
D55, D56: SMF20CA; D_SOD-123
J51: Line in; 3-5mm_connector
Q41, Q42, Q43: BSS138W; SOT-323_SC-70
R31: 10K; R_0402_1005Metric_Pad0.72x0.64mm_HandSolder JLC
R33: 100K; R_0402_1005Metric_Pad0.72x0.64mm_HandSolder JLC
R34: 2K2; R_0805_2012Metric_Pad1.20x1.40mm_HandSolder
R43, R44: 1K; R_2512_6332Metric_Pad1.40x3.35mm_HandSolder

Their connections:
+5V_PRIM: R31.1, R33.1; also elsewhere on the board
BT Enable: Q43.3 (D); also elsewhere on the board
Ext L: D43.2 (A), D45.1 (K), R43.2; also elsewhere on the board
Ext R: D47.2 (A), D49.1 (K), R44.2; also elsewhere on the board
In select A: Q41.3 (D); also elsewhere on the board
In select B: Q42.3 (D); also elsewhere on the board
LED 2: R34.2; also elsewhere on the board
unnamed 36: D12.1 (K); also elsewhere on the board
unnamed 40: R31.2; also elsewhere on the board
unnamed 45: D11.2 (A); also elsewhere on the board
unnamed 51: R34.1; also elsewhere on the board
unnamed 52: D43.1 (K); also elsewhere on the board
unnamed 53: D45.2 (A); also elsewhere on the board
unnamed 54: D47.1 (K); also elsewhere on the board
unnamed 55: D51.2 (A); also elsewhere on the board
unnamed 56: D51.1 (K), D52.2 (A); also elsewhere on the board
unnamed 57: D52.1 (K); also elsewhere on the board
unnamed 58: D53.2 (A); also elsewhere on the board
unnamed 59: D53.1 (K), D54.2 (A); also elsewhere on the board
unnamed 60: D54.1 (K); also elsewhere on the board
unnamed 61: D49.2 (A); also elsewhere on the board
unnamed 92: Q41.1 (G); also elsewhere on the board
unnamed 93: Q42.1 (G); also elsewhere on the board
unnamed 94: Q43.1 (G); also elsewhere on the board
Switch: R33.2; also elsewhere on the board
