Real-Exo/PP113/Portable Project 113 Headphone Amplifier/Kicad/BT Daughterboard/P113 BT Daughterboard.kicad_pcb

## KiCad design Portable Project 113 Headphone Amplifier/Kicad/BT Daughterboard/P113 BT Daughterboard.kicad_pcb (2024-12-13)

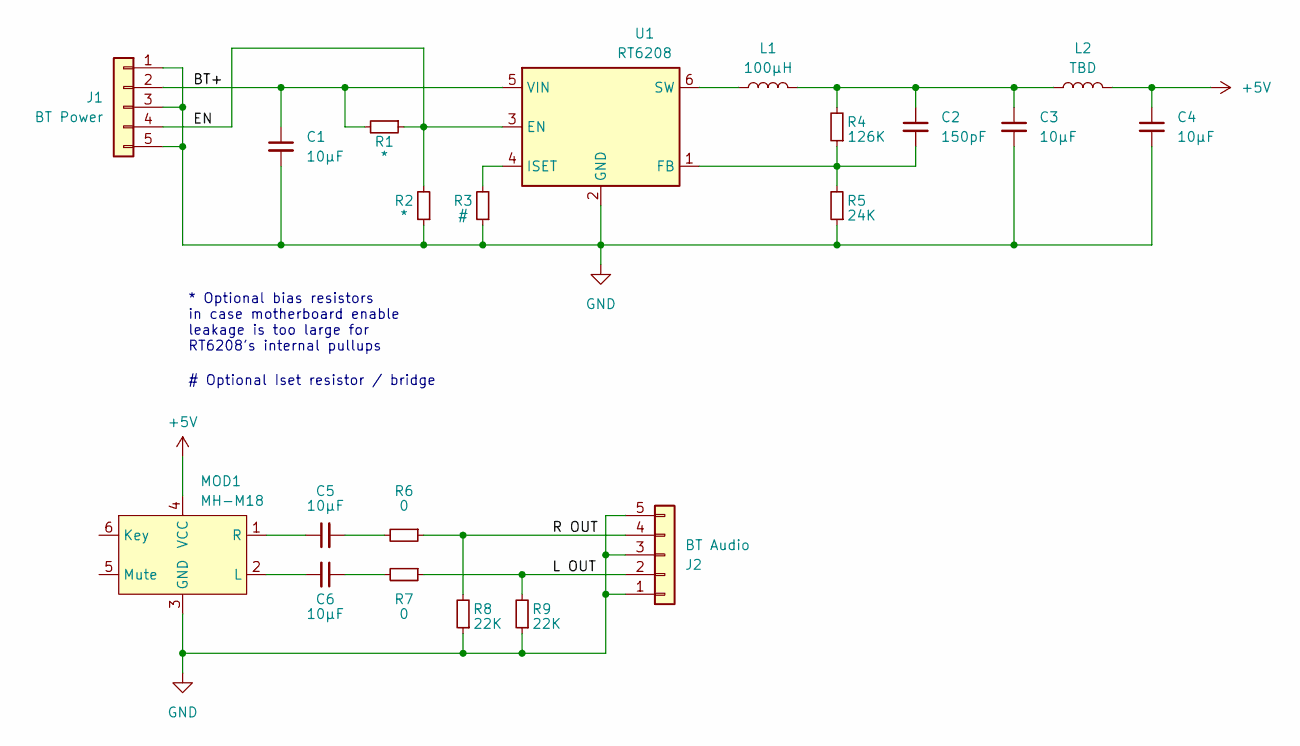
[picture p13: schematic P113 BT Daughterboard.kicad_sch]

Parts:
C1, C3, C4, C5, C6: 10µF; C_0805_2012Metric_Pad1.18x1.45mm_HandSolder
C2: 150pF; C_0805_2012Metric_Pad1.18x1.45mm_HandSolder
J1: BT Power; PinHeader_1x05_P2.54mm_Vertical
J2: BT Audio; PinHeader_1x05_P2.54mm_Vertical
L1: 100µH; L_Changjiang_FNR4026S
L2: TBD; L_Axial_L11.0mm_D4.5mm_P15.24mm_Horizontal_Fastron_MECC
MOD1: MH-M18
R1, R2: *; R_0805_2012Metric_Pad1.20x1.40mm_HandSolder
R3: #; R_0805_2012Metric_Pad1.20x1.40mm_HandSolder
R4: 126K; R_0805_2012Metric_Pad1.20x1.40mm_HandSolder
R5: 24K; R_0805_2012Metric_Pad1.20x1.40mm_HandSolder
R6, R7: 0; R_0805_2012Metric_Pad1.20x1.40mm_HandSolder
R8, R9: 22K; R_0805_2012Metric_Pad1.20x1.40mm_HandSolder
U1: RT6208; SOT-23-6

Connections:
+5V: C4.1, L2.2, MOD1.4 (VCC)
/BT+: C1.1, J1.2, R1.2, U1.5 (VIN)
/EN: J1.4, R1.1, R2.2, U1.3 (EN)
/L OUT: J2.2, R7.1, R9.2
/R OUT: J2.4, R6.1, R8.2
GND: C1.2, C3.2, C4.2, J1.1, J1.3, J1.5, J2.1, J2.3, J2.5, MOD1.3 (GND), R2.1, R3.1, R5.1, R8.1, R9.1, U1.2 (GND)
unnamed: C2.1, C3.1, L1.2, L2.1, R4.2
unnamed: C5.2, R6.2
unnamed: C6.1, R7.2
unnamed: C6.2, MOD1.2 (L)
unnamed: C5.1, MOD1.1 (R)
unnamed: C2.2, R4.1, R5.2, U1.1 (FB)
unnamed: R3.2, U1.4 (ISET)
unnamed: L1.1, U1.6 (SW)

Notes on the sheet:
* Optional bias resistors in case motherboard enable leakage is too large for RT6208's internal pullups
# Optional Iset resistor / bridge

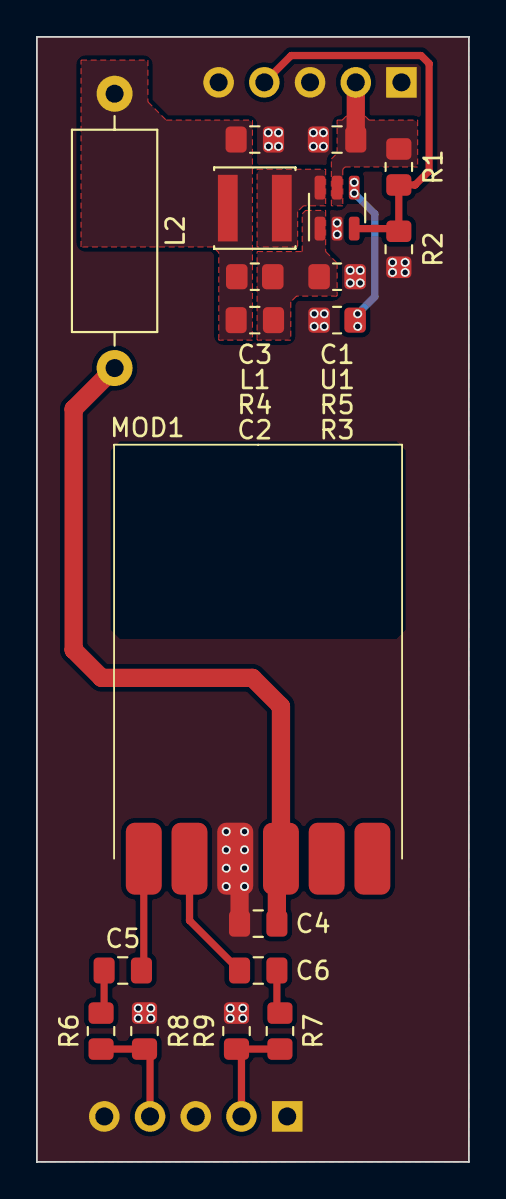
[picture p14: board P113 BT Daughterboard.kicad_pcb from above]

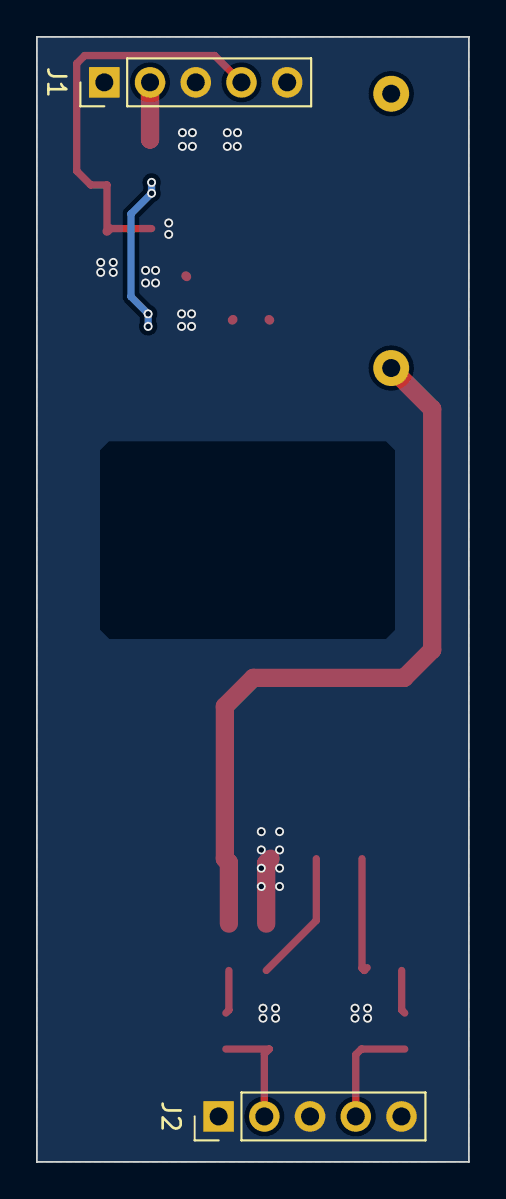
[picture p15: board P113 BT Daughterboard.kicad_pcb from below]

Board: 2 copper layers, 24.0 x 62.5 mm, 21 parts (2 on the bottom side), 14 nets.
