Real-Exo/PP113/Portable Project 113 Headphone Amplifier/Firmware/PP113.X/InputSelect.h

#ifndef INPUTSELECT_H
#define INPUTSELECT_H

void
INPUTSELECT_Init(void);

void
INPUTSELECT_BeforeSleep(void);

void
INPUTSELECT_LineIn(void);

void
INPUTSELECT_Bluetooth(void);

#endif //INPUTSELECT_H
