Real-Exo/PP113/Portable Project 113 Headphone Amplifier/Firmware/PP113.X/Switch.h

#ifndef SWITCH_H
#define SWITCH_H

#include <stdbool.h>

void
SWITCH_Init(void);

void
SWITCH_Sleep(void);

bool
SWITCH_LongPress(void);

bool
SWITCH_ShortPress(void);

void
SWITCH_ServiceTimer_100ms(void);

#endif //SWITCH
